webmeister/gps-cookie/firmware/firmware-atmega328p-screenshot.png

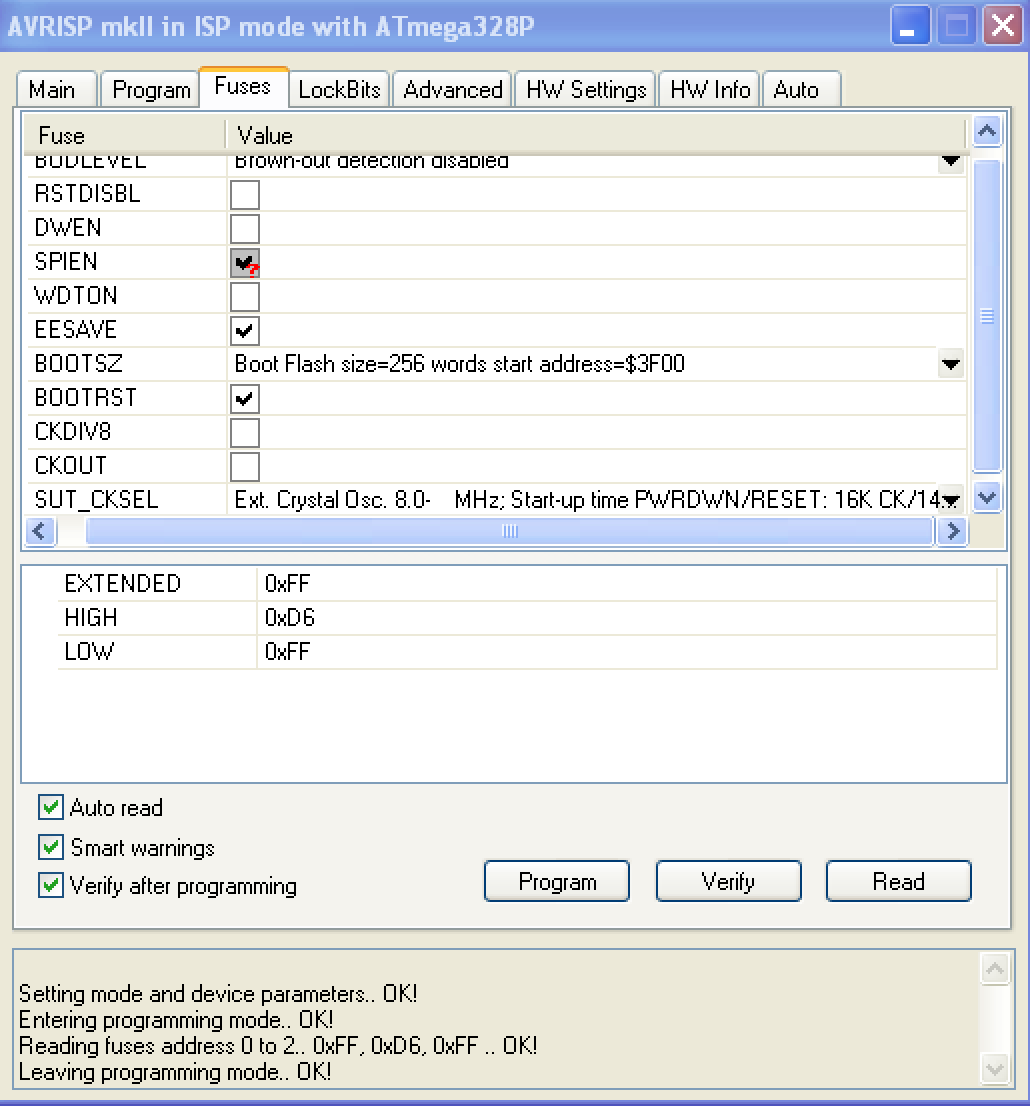
firmware/firmware-atmega328p-screenshot.png
