webmeister/gps-cookie/schematics/GPSCookieSCH.pdf

## RESET

J8, J9

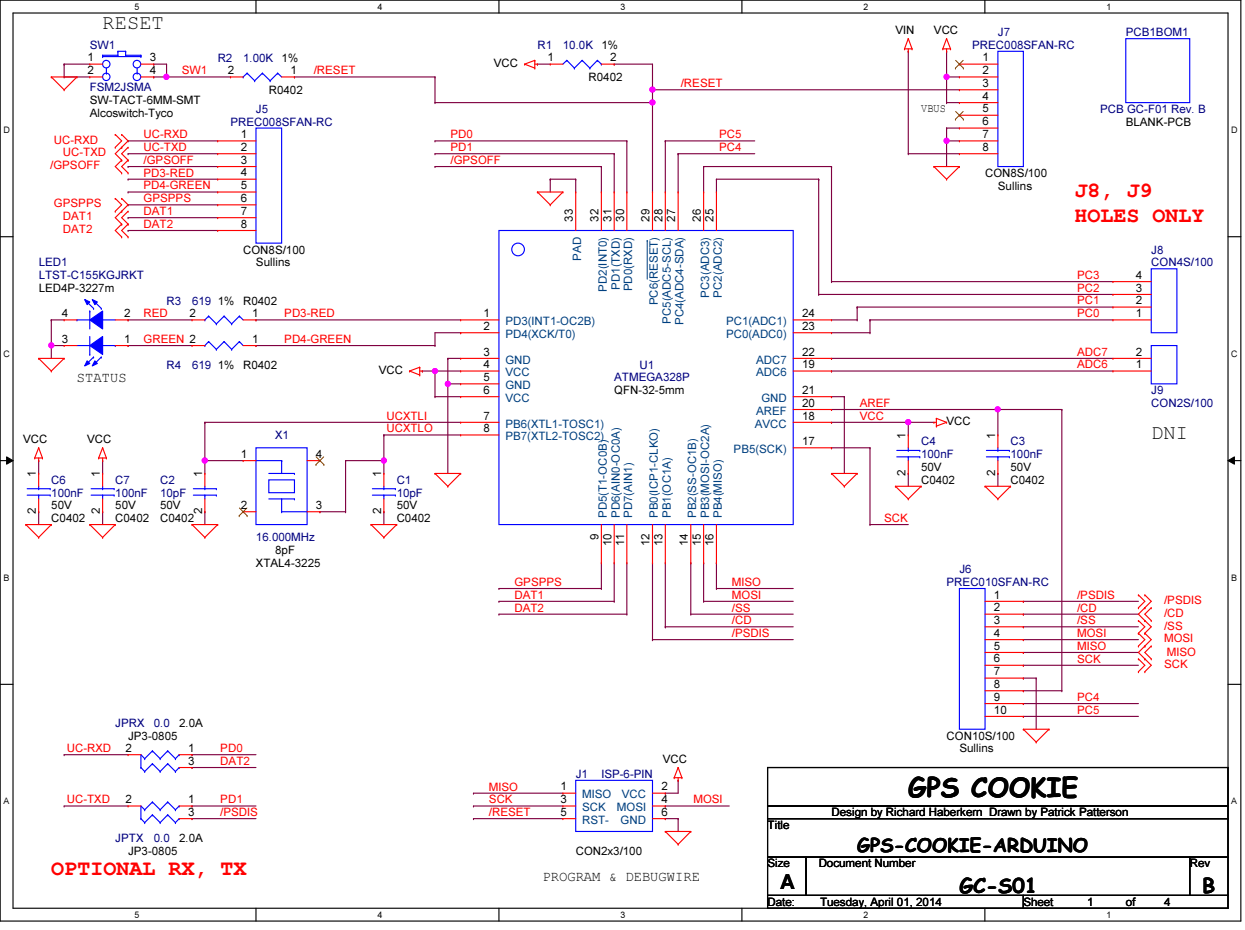
[picture p2: page 1]

Design by Richard Haberkern Drawn by Patrick Patterson
GPS-COOKIE-ARDUINO

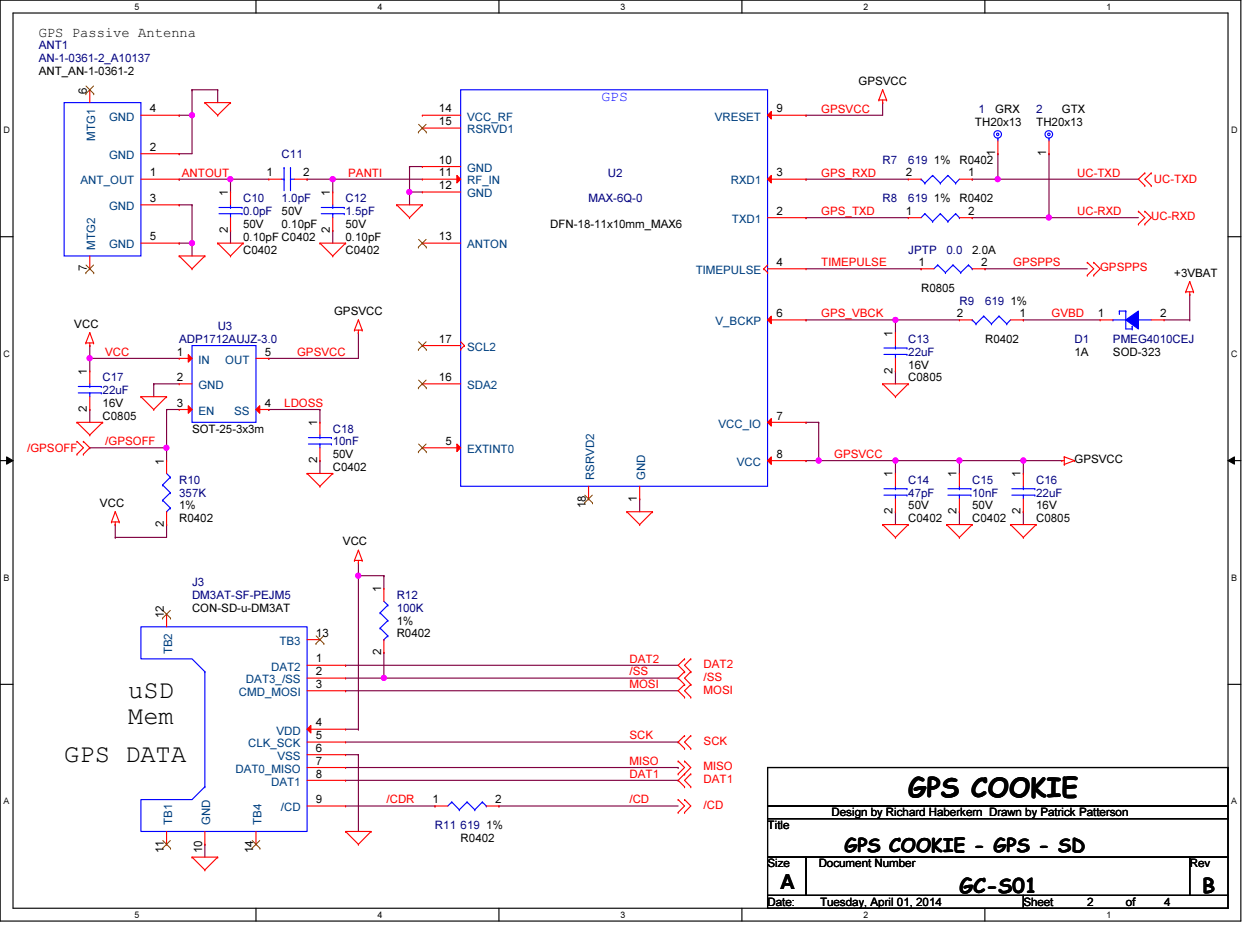
[picture p3: page 2]

Design by Richard Haberkern Drawn by Patrick Patterson
GPS COOKIE - GPS - SD

## EXT. PWR IN

## PWR ON

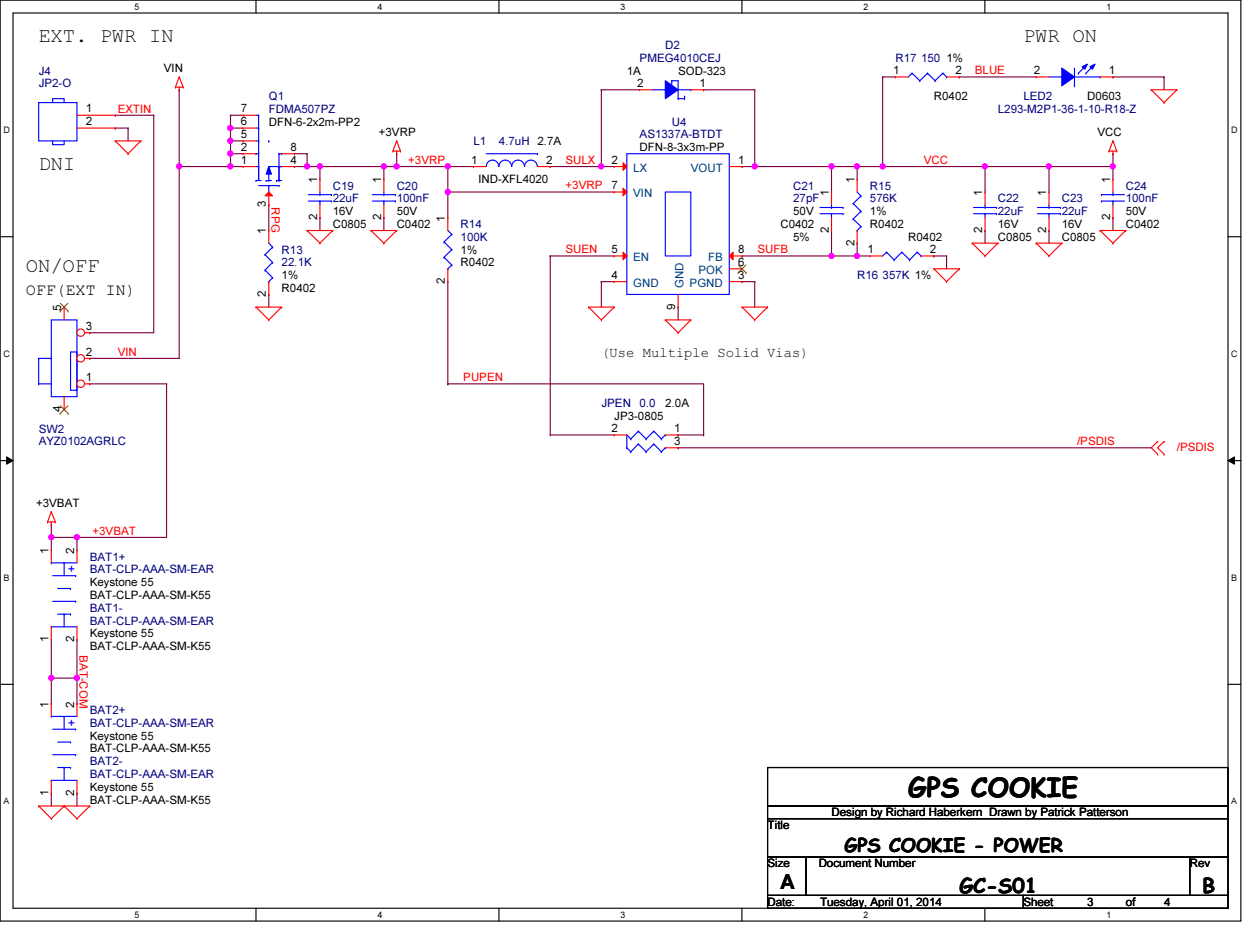
[picture p4: page 3]

(Use Multiple Solid Vias)

BAT1+
BAT-CLP-AAA-SM-EAR
Keystone 55
BAT-CLP-AAA-SM-K55
BAT1-

BAT2+
BAT2-

Design by Richard Haberkern Drawn by Patrick Patterson
GPS COOKIE - POWER

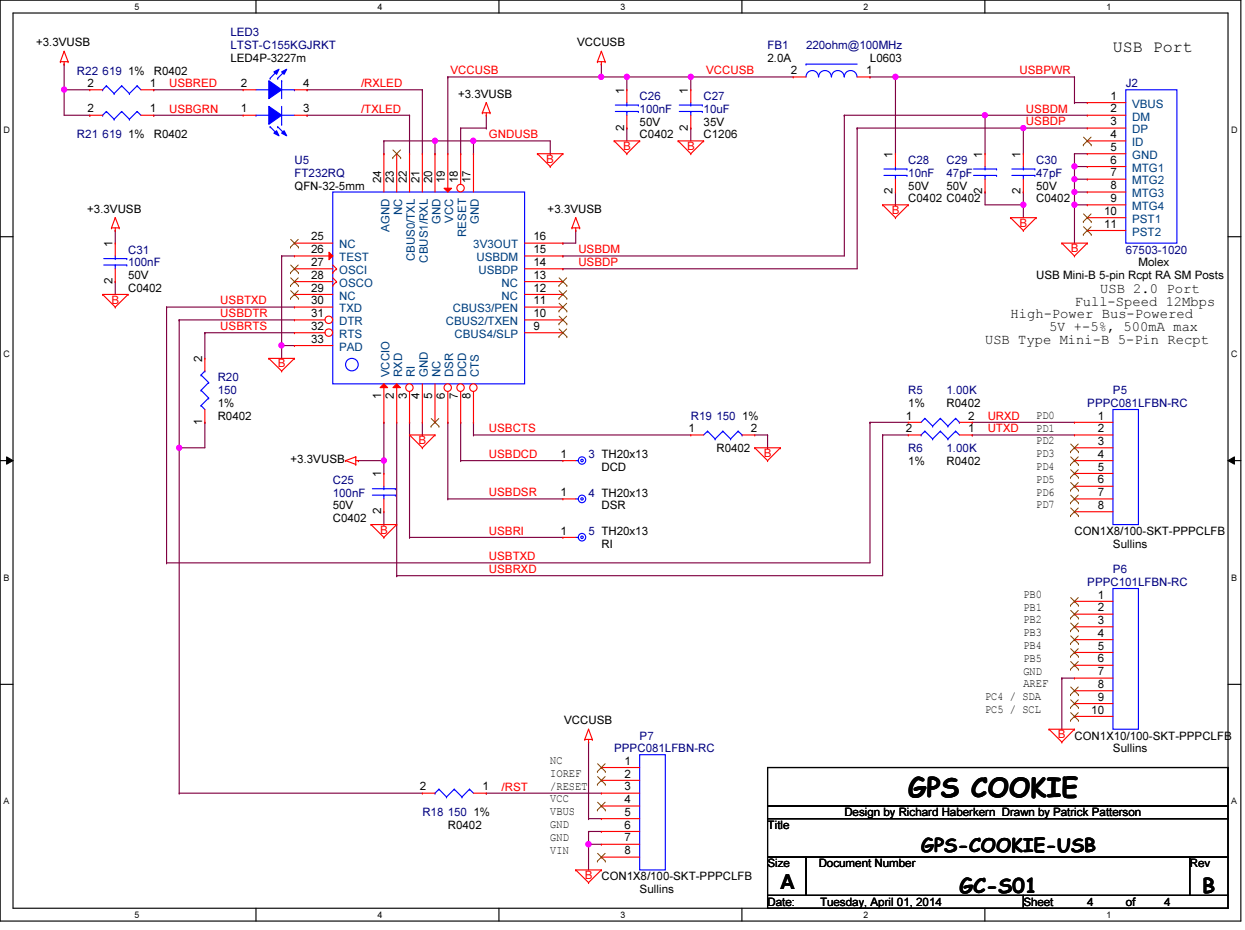
[picture p5: page 4]

USB Mini-B 5-pin Rcpt RA SM Posts

High-Power Bus-Powered

USB Type Mini-B 5-Pin Recpt

Design by Richard Haberkern Drawn by Patrick Patterson
