webmeister/gps-cookie/(commit log)

2014-06-17 GPS Cookie project files
    [GC-S01_GPS-Cookie_BOM_RevB.xls]
2014-06-17 README updates
    [GC-S01_GPS-Cookie_BOM_RevB.xls]
2015-08-09 Add version 2 of the firmware with several new features
    * Correct timestamps for log files
    * Single log file per day
    * Power saving mode
    * LEDs light up iff the device is busy executing code
    * GPS configuration via config file
    [GPSCookieV2.ino]
2015-08-16 Implement advanced powersaving modes
    [config.txt]
